Stefal/V4MPod/(threads)

Thread 13 (2019-09-16):

v4mpod: not so good sync

Stefal, 2019-09-16:
J'ai l'impression que la géoloc n'est pas toujours très bonnes, malgré les traces RTK. Une possibilité d'explication serait que l'horloge du Pi n'est pas bien synchronisée sur celle du récepteur.
Sur le test du 2019-09-13, les photos sont trop loin sur la trace, d'environ 400ms
