Stefal/V4MPod/kicad/Yi remote/Yi remote.pdf

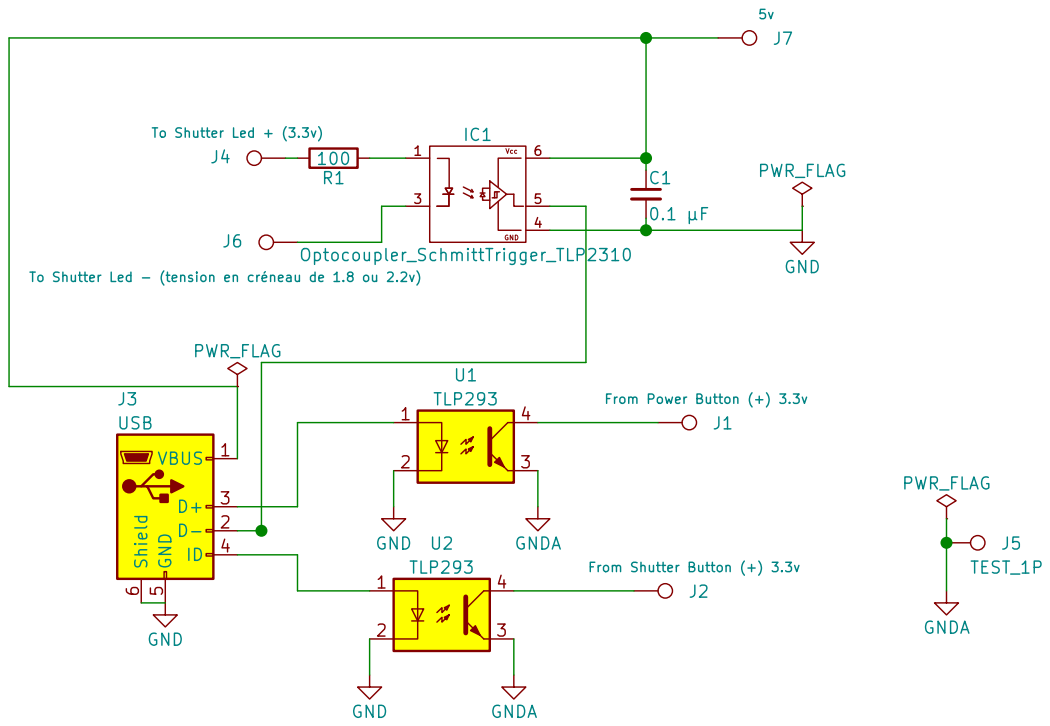
[picture p1: page 1]

To Shutter Led - (tension en créneau de 1.8 ou 2.2v) R1

Id: 1/1 Title: Yi 2K Remote in/out File: Yi remote.sch Sheet: /
