Stefal/V4MPod/kicad/Arduino Cam Shield/Cam Shiel.kicad_pcb

## KiCad design kicad/Arduino Cam Shield/Cam Shiel.kicad_pcb (2017-09-05)

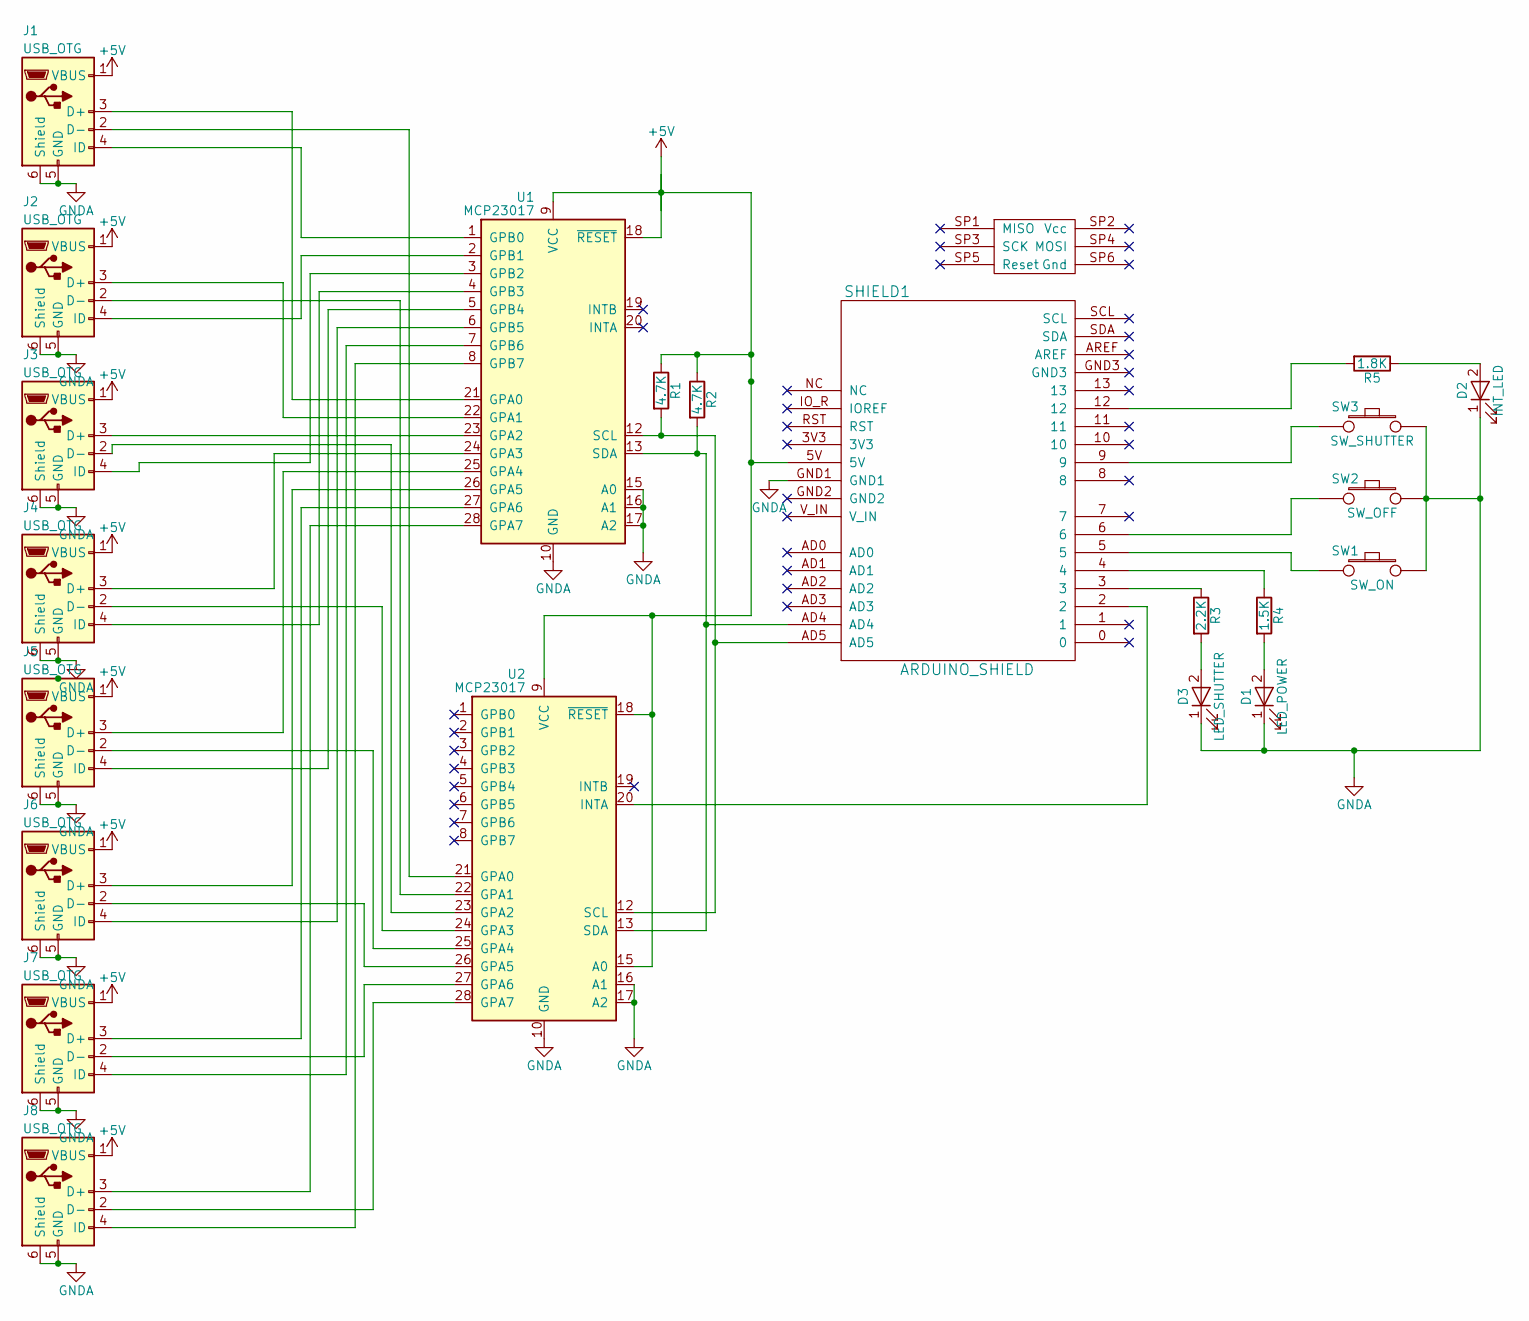
[picture p2: schematic Cam Shiel.sch]

Parts:
D1: LED_POWER; LED_0805
D2: INT_LED; LED_0805
D3: LED_SHUTTER; LED_0805
J1, J2, J3, J4, J5, J6, J7, J8: USB_OTG; USB_Micro-B_Molex-105017-0001
R1, R2: 4.7K; R_0805_HandSoldering
R3: 2.2K; R_0805_HandSoldering
R4: 1.5K; R_0805_HandSoldering
R5: 1.8K; R_0805_HandSoldering
SHIELD1: ARDUINO_SHIELD
SW1: SW_ON; SW_PUSH_6mm
SW2: SW_OFF; SW_PUSH_6mm
SW3: SW_SHUTTER; SW_PUSH_6mm
U1, U2: MCP23017; DIP-28_W7.62mm_Socket_LongPads

Connections:
+5V: J1.1 (VBUS), J2.1 (VBUS), J3.1 (VBUS), J4.1 (VBUS), J5.1 (VBUS), J6.1 (VBUS), J7.1 (VBUS), J8.1 (VBUS), R1.1, R2.1, SHIELD1.5V, U1.9 (VCC), U1.18 (~RESET), U2.9 (VCC), U2.15 (A0), U2.18 (~RESET); also elsewhere on the board
GNDA: D1.1 (K), D2.1 (K), D3.1 (K), J1.5 (GND), J1.6 (Shield), J2.5 (GND), J2.6 (Shield), J3.5 (GND), J3.6 (Shield), J4.5 (GND), J4.6 (Shield), J5.5 (GND), J5.6 (Shield), J6.5 (GND), J6.6 (Shield), J7.5 (GND), J7.6 (Shield), J8.5 (GND), J8.6 (Shield), SHIELD1.GND1, SW1.2, SW2.2, SW3.2, U1.10 (GND), U1.15 (A0), U1.16 (A1), U1.17 (A2), U2.10 (GND), U2.16 (A1), U2.17 (A2); also elsewhere on the board
unnamed: D1.2 (A), R4.2
unnamed: D2.2 (A), R5.1
unnamed: D3.2 (A), R3.2
unnamed: J1.2 (D-), U2.21 (GPA0)
unnamed: J1.3 (D+), U1.21 (GPA0)
unnamed: J1.4 (ID), U1.1 (GPB0)
unnamed: J2.2 (D-), U2.22 (GPA1)
unnamed: J2.3 (D+), U1.22 (GPA1)
unnamed: J2.4 (ID), U1.2 (GPB1)
unnamed: J3.2 (D-), U2.23 (GPA2)
unnamed: J3.3 (D+), U1.23 (GPA2)
unnamed: J3.4 (ID), U1.3 (GPB2)
unnamed: J4.2 (D-), U2.24 (GPA3)
unnamed: J4.3 (D+), U1.24 (GPA3)
unnamed: J4.4 (ID), U1.4 (GPB3)
unnamed: J5.2 (D-), U2.25 (GPA4)
unnamed: J5.3 (D+), U1.25 (GPA4)
unnamed: J5.4 (ID), U1.5 (GPB4)
unnamed: J6.2 (D-), U2.26 (GPA5)
unnamed: J6.3 (D+), U1.26 (GPA5)
unnamed: J6.4 (ID), U1.6 (GPB5)
unnamed: J7.2 (D-), U2.27 (GPA6)
unnamed: J7.3 (D+), U1.27 (GPA6)
unnamed: J7.4 (ID), U1.7 (GPB6)
unnamed: J8.2 (D-), U2.28 (GPA7)
unnamed: J8.3 (D+), U1.28 (GPA7)
unnamed: J8.4 (ID), U1.8 (GPB7)
unnamed 29: R1.2, SHIELD1.AD5, U1.12 (SCL), U2.12 (SCL); also elsewhere on the board
unnamed 30: R2.2, SHIELD1.AD4, U1.13 (SDA), U2.13 (SDA); also elsewhere on the board
unnamed 31: R3.1, SHIELD1.3; also elsewhere on the board
unnamed 32: R4.1, SHIELD1.4; also elsewhere on the board
unnamed 33: R5.2, SHIELD1.12; also elsewhere on the board
unnamed 36: SHIELD1.2, U2.20 (INTA); also elsewhere on the board
unnamed 37: SHIELD1.5, SW1.1; also elsewhere on the board
unnamed 38: SHIELD1.6, SW2.1; also elsewhere on the board
unnamed 41: SHIELD1.9, SW3.1; also elsewhere on the board

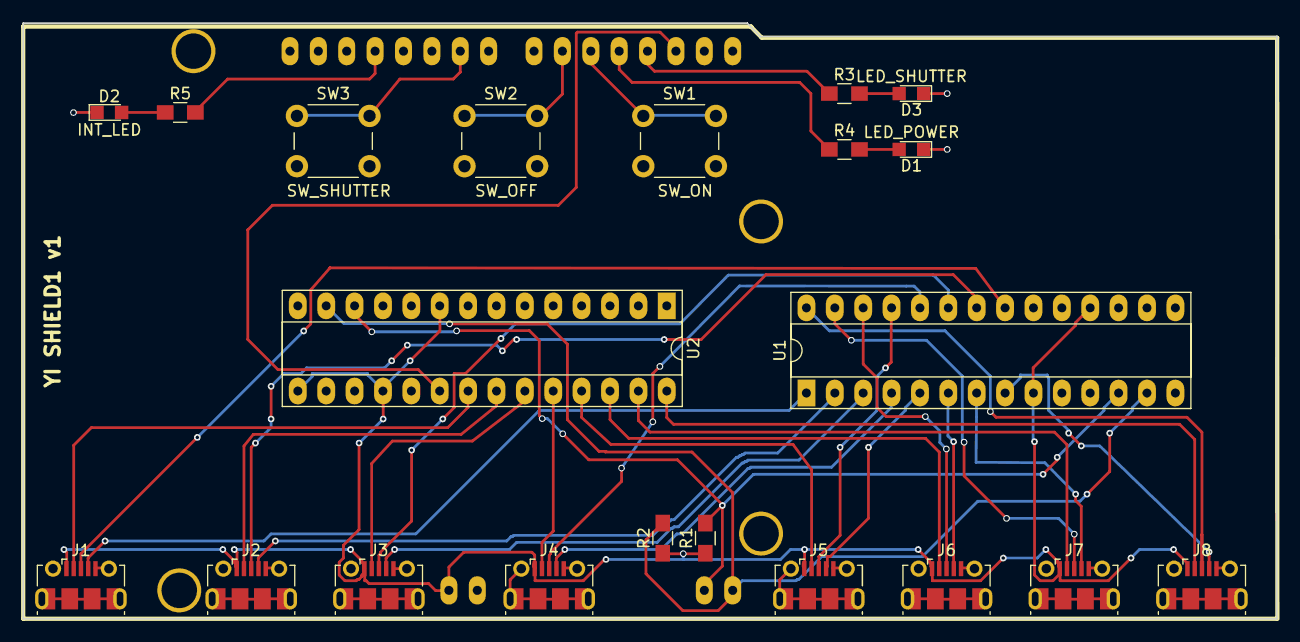
[picture p3: board Cam Shiel.kicad_pcb from above]

Board: 2 copper layers, 112.2 x 53.3 mm, 22 parts (0 on the bottom side), 38 nets.

Other parts of the board:
YI SHIELD1 v1: ARDUINO_SHIELD

Their connections:
+5V: YI SHIELD1 v1.5V; also elsewhere on the board
GNDA: YI SHIELD1 v1.GND1; also elsewhere on the board
unnamed 29: YI SHIELD1 v1.AD4; also elsewhere on the board
unnamed 30: YI SHIELD1 v1.AD5; also elsewhere on the board
unnamed 31: YI SHIELD1 v1.3; also elsewhere on the board
unnamed 32: YI SHIELD1 v1.4; also elsewhere on the board
unnamed 33: YI SHIELD1 v1.12; also elsewhere on the board
unnamed 36: YI SHIELD1 v1.2; also elsewhere on the board
unnamed 37: YI SHIELD1 v1.5; also elsewhere on the board
unnamed 38: YI SHIELD1 v1.6; also elsewhere on the board
unnamed 41: YI SHIELD1 v1.9; also elsewhere on the board
