Stefal/V4MPod/kicad/Yi remote/Yi remote.kicad_pcb

## KiCad design kicad/Yi remote/Yi remote.kicad_pcb (2017-09-04)

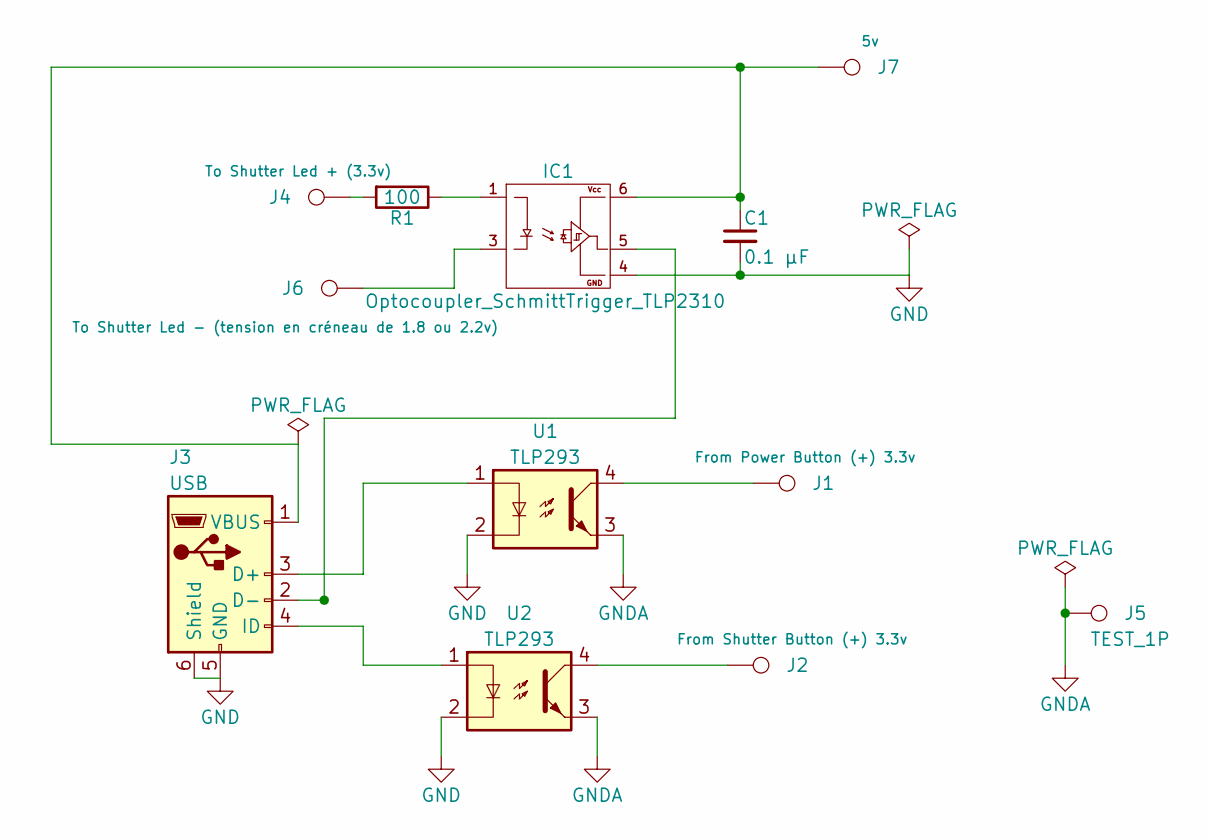
[picture p4: schematic Yi remote.sch, Yi 2K Remote in/out]

Parts:
C1: 0.1 µF; C_0402
IC1: Optocoupler_SchmittTrigger_TLP2310; SO-6_5_pins
J1: From Power Button (+) 3.3v; SolderWirePad_single_0-8mmDrill
J2: From Shutter Button (+) 3.3v; SolderWirePad_single_0-8mmDrill
J3: USB; USB_Mirco-B_Molex-105017-0001
J4: To Shutter Led + (3.3v); SolderWirePad_single_0-8mmDrill
J5: TEST_1P; SolderWirePad_single_0-8mmDrill
J6: To Shutter Led - (tension en créneau de 1.8 ou 2.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; SolderWirePad_single_0-8mmDrill
J7: 5v; SolderWirePad_single_0-8mmDrill
R1: 100; R_0402
U1, U2: TLP293; SOP-4_4.4x2.8mm_Pitch1.27mm_3D

Connections:
GND: C1.2, IC1.4, J3.5 (GND), J3.6 (Shield), U1.2, U2.2
GNDA: J5.1, U1.3, U2.3
unnamed: C1.1, IC1.6, J3.1 (VBUS), J7.1
unnamed: IC1.1, R1.1
unnamed: IC1.3, J6.1
unnamed: IC1.5, J3.2 (D-)
unnamed: J1.1, U1.4
unnamed: J2.1, U2.4
unnamed: J3.3 (D+), U1.1
unnamed: J3.4 (ID), U2.1
unnamed: J4.1, R1.2

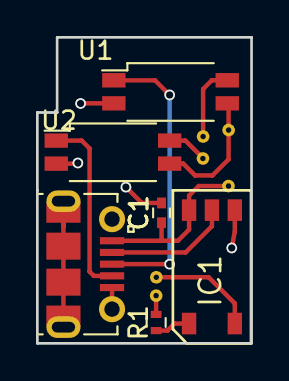
[picture p5: board Yi remote.kicad_pcb from above]

Board: 2 copper layers, 11.9 x 17.0 mm, 12 parts (0 on the bottom side), 11 nets.
