Stefal/V4MPod/kicad/Raspberry Cam Shield/Raspberry Cam Shield.kicad_pcb

## KiCad design kicad/Raspberry Cam Shield/Raspberry Cam Shield.kicad_pcb (2017-09-05)

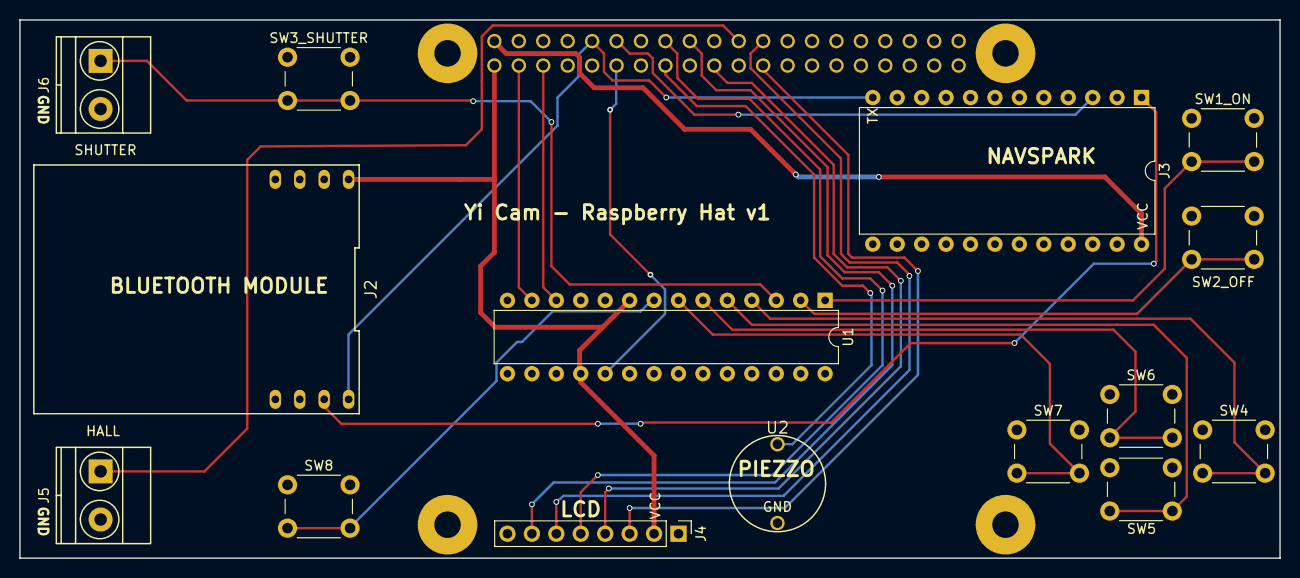
[picture p6: board Raspberry Cam Shield.kicad_pcb from above]

Board: 2 copper layers, 131.0 x 55.9 mm, 16 parts (0 on the bottom side), 24 nets.

Parts:
J1: Raspberry_Pi_2_3; RASPBERRY_PI_HAT
J2: DIL8; DIP-8_2_ROW_W22.86_BLUETOOTH
J3: DIL24; DIP-24_W15.24mm
J4: CONN_01X08_LCD; Pin_Header_Straight_1x08_Pitch2.54mm
J5: Screw_Terminal_Hall_Sensor; TerminalBlock_Pheonix_MKDS1.5-2pol
J6: Screw_Terminal_Shutter_Switch; TerminalBlock_Pheonix_MKDS1.5-2pol
SW1_ON, SW2_OFF, SW3_SHUTTER, SW4, SW5, SW6, SW7, SW8: SW_PUSHBUTTON; SW_PUSH_6mm_h5mm
U1: MCP23017; DIP-28_W7.62mm
U2: BUZZER; PIEZZO_BUZZER

Connections:
+3V3: J1.1, J2.1, J4.2, U1.9, U1.18
/Battery_(5v): J1.2, J3.24
/CLK: J1.23, J4.3
/CS: J1.24, J4.6
/D/C: J1.16, J4.5
/DIN: J1.19, J4.4
/PPS: J1.12, J3.3
/RST: J1.18, J4.7
/TX: J1.10, J2.8, J3.12
GNDA: J1.39, J2.2, J3.21, J4.1, J5.2, J6.2, SW1_ON.1, SW2_OFF.1, SW3_SHUTTER.1, SW4.1, SW5.1, SW6.1, SW7.1, SW8.1, U1.10, U1.15, U1.16, U1.17, U2.2
unnamed: J1.3, U1.13
unnamed: J1.5, U1.12
unnamed: J1.11, U1.19
unnamed: J1.15, U2.1
unnamed: J1.22, J5.1
unnamed: J2.7, J3.1
unnamed: J6.1, SW3_SHUTTER.2, U1.3
unnamed: SW1_ON.2, U1.1
unnamed: SW2_OFF.2, U1.2
unnamed: SW4.2, U1.4
unnamed: SW5.2, U1.5
unnamed: SW6.2, U1.6
unnamed: SW7.2, U1.7
unnamed: SW8.2, U1.8
