Stefal/V4MPod/kicad/Yi remote/Yi remote_v1.kicad_pcb

## KiCad design kicad/Yi remote/Yi remote_v1.kicad_pcb (2017-09-04)

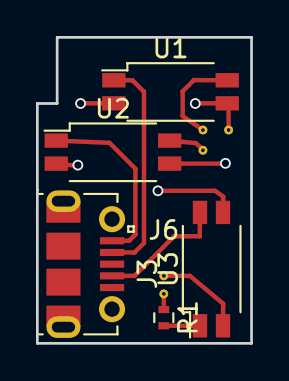
[picture p7: board Yi remote_v1.kicad_pcb from above]

Board: 2 copper layers, 11.9 x 17.0 mm, 10 parts (0 on the bottom side), 10 nets.

Parts:
J1: To Power Button (+); SolderWirePad_single_0-8mmDrill
J2: To Shutter Button (+); SolderWirePad_single_0-8mmDrill
J3: USB; USB_Mirco-B_Molex-105017-0001
J4: To Shutter Led + (3.3v); SolderWirePad_single_0-8mmDrill
J5: TEST_1P; SolderWirePad_single_0-8mmDrill
J6: To Shutter Led - (1.8 ou 2.2v); SolderWirePad_single_0-8mmDrill
R1: 1,2K; R_0402
U1, U2: VO615A; SOP-4_4.4x2.8mm_Pitch1.27mm_3D
U3: SHT_LED; SOP-4_4.4x2.8mm_Pitch1.27mm_3D

Connections:
GND: J3.5, J3.6, U1.2, U2.2, U3.3
GNDA: J5.1, U1.3, U2.3
unnamed: J1.1, U1.4
unnamed: J2.1, U2.4
unnamed: J3.1, U2.1
unnamed: J3.2, U1.1
unnamed: J3.4, U3.4
unnamed: J4.1, R1.1
unnamed: J6.1, U3.2
unnamed: R1.2, U3.1
