Stefal/V4MPod/raspberry/lcd_menu.py

#!/usr/bin/env python
# -*- coding: utf-8 -*-
import time
import Adafruit_Nokia_LCD as LCD
import Adafruit_GPIO.SPI as SPI

from PIL import Image
from PIL import ImageDraw
from PIL import ImageFont
from PIL import ImageOps
from PIL import ImageMath



def create_full_img(menu_list):
    #Create an image containing all the menus
    image = Image.new('1', (LCD.LCDWIDTH,len(menu_list)*11+LCD.LCDHEIGHT))
    draw = ImageDraw.Draw(image)
    font = ImageFont.load_default()
    draw.rectangle((0,0,LCD.LCDWIDTH,len(menu_list)*11+LCD.LCDHEIGHT), outline=255, fill=255)
    
    # Write the menu
    for y,elt in enumerate(menu_list):
        draw.text((1,(y*11)), elt["Name"], font=font)
    return image

def create_blanck_img():
    #Create a blank image with the lcd size
    image = Image.new('1', (LCD.LCDWIDTH, LCD.LCDHEIGHT))
    draw = ImageDraw.Draw(image)
    font = ImageFont.load_default()
    draw.rectangle((0,0,LCD.LCDWIDTH,LCD.LCDHEIGHT), outline=255, fill=255)
    return image
    
def crop_img(img, line):
    xsize, ysize = img.size
    if (11*(line-1)+11) <= LCD.LCDHEIGHT:
        line=4
    return img.crop((0,(11*(line-4)), LCD.LCDWIDTH, (11*(line-4)+48)))
    
def invert(img):
    img=img.convert('L')
    img = ImageOps.invert(img)
    img = img.convert('1')
    return img

def create_mask(y1, y2, background_img):
    xsize, ysize = background_img.size
    mask = Image.new('1', (xsize, ysize))
    draw = ImageDraw.Draw(mask)
    draw.rectangle((0,0,xsize,ysize), outline=0, fill=0)
    draw.rectangle((0,y1,xsize,y2), outline=255, fill=255)
    return mask

def display_img(img, lcd):
    lcd.image(img)
    lcd.display()


def img_xor(img1, img2):
    print("img1 size = ", img1.size)
    print("img2 size = ", img2.size)
    return ImageMath.eval("convert((a^b), '1')", a=img1, b=img2)
    
def menu_loop2(full_img, menu):
    for x,elt in enumerate(menu):
        mask=create_mask(11*x, 11*(x+1), full_img)
        out=img_xor(full_img,mask)
        out=crop_img(out,x+1)
        back.paste(out, (0,0, LCD.LCDWIDTH, LCD.LCDHEIGHT))
        disp.image(out)
        disp.display()
        time.sleep(1)
    for x,elt in reversed(list(enumerate(menu))):
        mask=create_mask(11*x, 11*(x+1), full_img)
        out=img_xor(full_img,mask)
        out=crop_img(out,x+1)
        back.paste(out, (0,0, LCD.LCDWIDTH, LCD.LCDHEIGHT))
        disp.image(out)
        disp.display()
        time.sleep(1)


def select_line(full_img, background_img, line, LCD_display):
    #Highlight a line in the full menu, crop it to the lcd size
    #then display it
    #full_img : the image with all the menus
    #line : the line you want to highlight
    mask=create_mask(11*(line-1), 11*(line), full_img)
    out=img_xor(full_img,mask)
    out=crop_img(out,line)
    background_img.paste(out, (0,0, LCD.LCDWIDTH, LCD.LCDHEIGHT))
    LCD_display.image(out)
    LCD_display.display()
    return out

#menu0=["Menu 1", "Menu 2", "Menu 3 tiop", "Menu 4 ppprfgi", "Menu 5", "Menu 6 ERgp", "MENU7 ttyipg$^ù*§", "MENU8 ttyipg$^ù*§", "menu 9", "MENU 10 "]
#img2=create_full_img(menu0)
#back=create_blanck_img()
