Stefal/V4MPod/raspberry/flask_forms.py

from flask_wtf import FlaskForm
from wtforms import StringField, PasswordField, BooleanField, SubmitField
from wtforms.validators import DataRequired

class SessionForm(FlaskForm):
    session_name = StringField('New Session Name', validators=[DataRequired()])
    new_gnss = BooleanField('New Gnss File')
    submit = SubmitField('Send')

class LoginForm(FlaskForm):
    password = PasswordField('Password', validators=[DataRequired()])
    remember_me = BooleanField('Remember Me')
    submit = SubmitField('Sign in')
