Stefal/V4MPod/(commit log)

2017-05-10 Adding arduino sketch
2017-05-12 update to use mcp interrupts
2017-05-14 interrupt management
2017-05-15 Add CmdMessenger
    Add CmdMessenger to control the Arduino with a Raspberry Pi +
    PyCmdMessenger
2017-05-31 Adding raspberry script
2017-09-04 Add PCB
    Internal Yi PCB
    [Yi remote-B.Cu.gbl, Yi remote-B.Mask.gbs, Yi remote-B.SilkS.gbo, Yi remote-Edge.Cuts.gm1, Yi remote-F.Cu.gtl, Yi remote-F.Mask.gts, Yi remote-F.SilkS.gto, Yi remote.drl]
2017-09-05 Add PCB
    [Yi remote-B.Cu.gbl, Yi remote-B.Mask.gbs, Yi remote-B.SilkS.gbo, Yi remote-Edge.Cuts.gm1, Yi remote-F.Cu.gtl, Yi remote-F.Mask.gts, Yi remote-F.SilkS.gto, Yi remote.drl]
2017-11-18 Adding correlate with log
    Adding the script that correlate the picture from the cams with the log
    generated on the raspberry pi
    [profile.cfg]
2017-12-06 Add python script for the raspberry pi
2018-05-14 Convert odometer class to a threading object
2018-05-15 Retrieving the modified code from the use raspberry
2018-06-29 Add correlate_with_log2
    Partial rewrite of correlate_with_log.
    Work in Progress
    [profile.cfg]
2018-08-17 new exif module
    [profile.cfg]
2018-08-28 Add hall sensor test script
2018-08-28 Add hall.py
2018-08-28 Fix int flag name
    [v4mpod.py]
2018-09-18 Update hall
2018-09-21 Import Queue instead of import from Needed for correct exception raising
    [v4mpack.py]
2018-09-30 Switch from pyexiv2 to Exifread
2018-10-09 Add some conditions and more talker id
    Add some condition in correlate_with_log to check the metadata
    availability
    Add more gnss talkerId for a better nmea parser
    [profile.cfg]
2019-01-04 Use image list with missing timestamp
    Use image list with missing timestamp inserted with
    insert_missing_timestamp function
2019-01-04 add condition on elevation interpolation
    When gpx are manually edited, elevation is sometime missing. In this
    case, after[3] could be "None".
    This commit add the condition to not have a float + None operand.
2019-01-20 Managing Case difference in path
2019-04-09 convert copy_pic to python3
    [profile.cfg]
2019-04-15 convert code to python3
    [Raspberry Cam Shield-2019-04-11-13-48-21.sch]
2020-03-09 Adding try/except on sendind clock/settings to the Yi camera
2020-03-22 Adding storage and battery request
2020-03-24 replace CRLF line ending to LF
    [Yi2K_ctrl.py]
2020-03-27 Checking is a cam is already on/off before powering it off/on
2020-03-30 Moving button class to the <a href=...>
2021-07-12 V4MPod upgrade to V6Mpod
    [profile.cfg]
2021-07-13 Adding U-Blox F9R config backup
    [config.txt]
2021-07-15 Arduino update
    Update to compil the sketch with the official arduino app
2021-07-16 Update config.txt
    adding nmea gst message
    [config.txt]
2021-07-30 add missing files and some fixes for python 3.8
    [config.txt, profile.cfg]
2022-04-14 Switch buzzer pin to 25 buzzer moved from the pcb to the manual shutter button enclosure
    [v4mpack.py]
2022-04-14 disable fix mandatory at startup as it's not a good idea when I start the v6mpack indoor.
    [v4mpack.py]
2022-04-14 refresh cams' clock every 60s. I was tired of waiting for the clock sync after 60 seconds without taking a picture.
2022-04-14 wrong route fixed. this route was called by http://localhost/favicon.ico
    [v4mpack.py]
2022-04-15 Switch cams to photo mode
2022-04-15 Adding a way to power up cam when status is unknown
2022-04-15 Adding new buttons to web pages
2022-04-15 add profile
    [profile.cfg]
2022-04-15 Create config_F9R_V6MPack_firm1.21.txt
    Add configuration for new F9R firmware (1.21)
    [config_F9R_V6MPack_firm1.21.txt]
2022-08-31 Update profile.cfg
    Adding profile for 360 images
    [profile.cfg]
